wkaczurba/starter-pistol/docs/assets/away_small/away_small.jpg

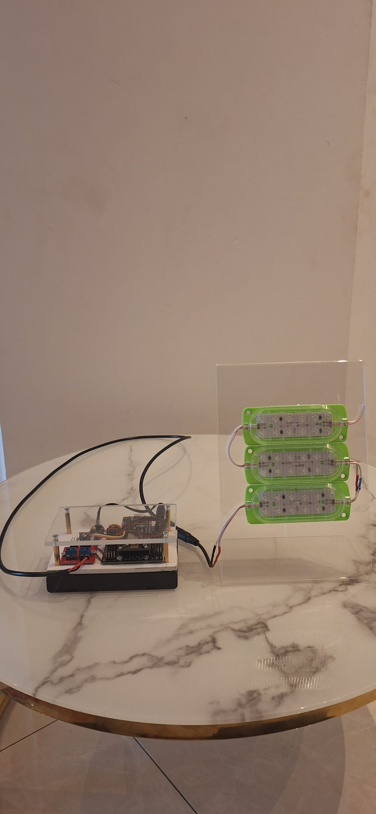
docs/assets/away_small/away_small.jpg
