wkaczurba/starter-pistol/docs/assets/horizontal/horizontal_led_off1.jpg

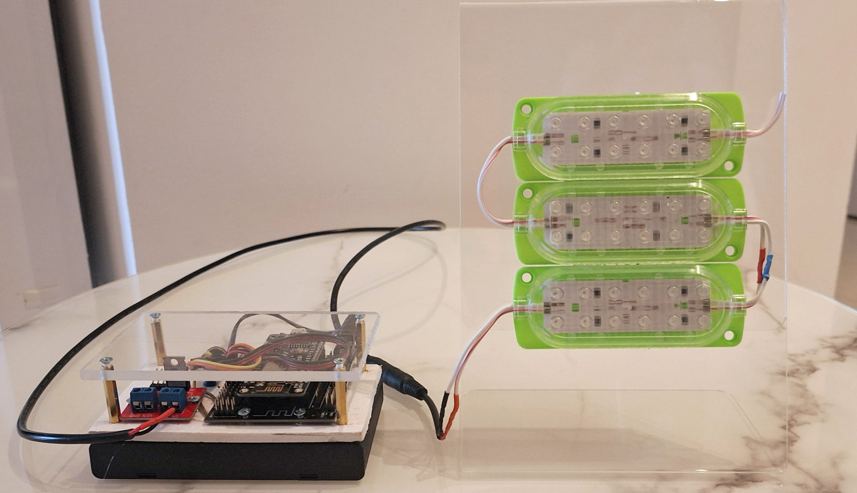
docs/assets/horizontal/horizontal_led_off1.jpg
