wkaczurba/starter-pistol/docs/assets/horizontal/horizontal_led_on1.jpg

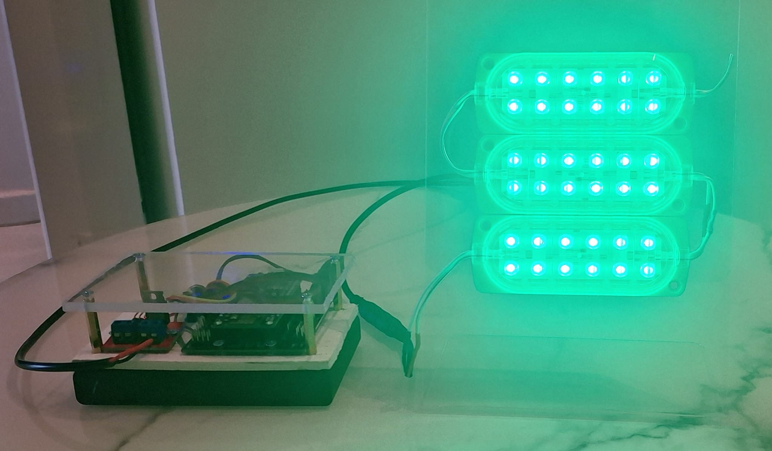
docs/assets/horizontal/horizontal_led_on1.jpg
