wkaczurba/starter-pistol/docs/assets/horizontal/horizontal_led_on2.jpg

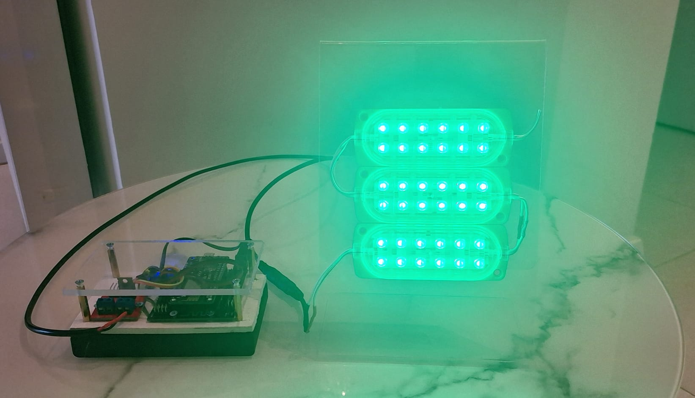
docs/assets/horizontal/horizontal_led_on2.jpg
