wkaczurba/starter-pistol/docs/assets/stacked_zoomedin/stacked1.jpg

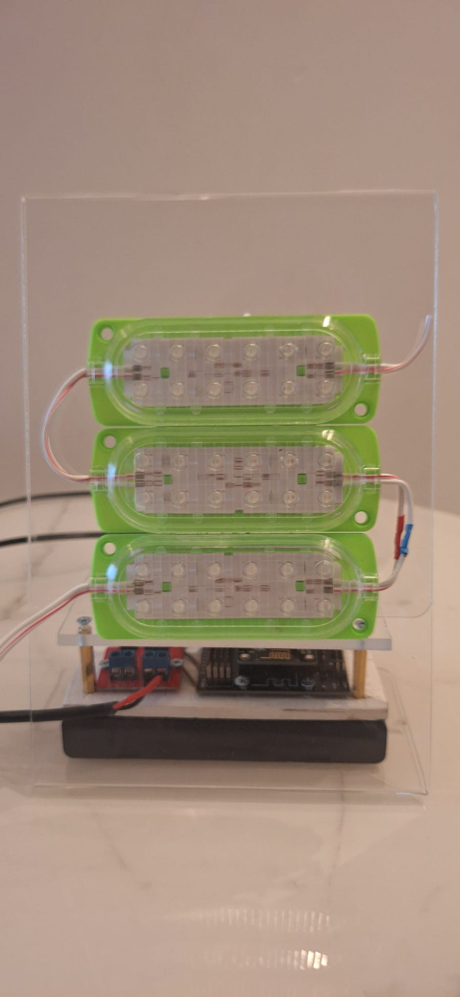
docs/assets/stacked_zoomedin/stacked1.jpg
