wkaczurba/starter-pistol/docs/assets/stacked_zoomedin/stacked2.jpg

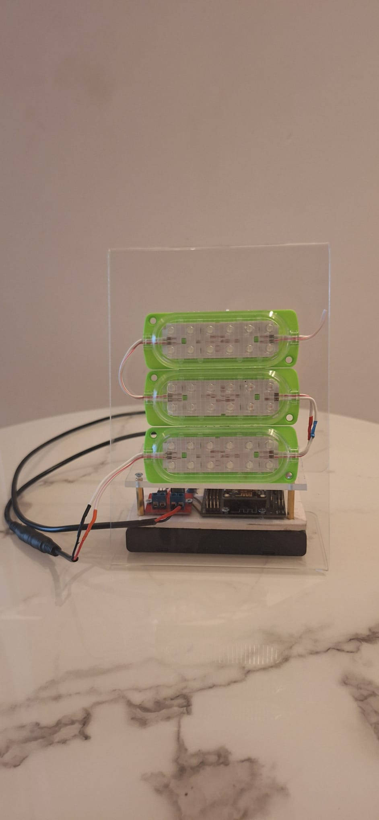
docs/assets/stacked_zoomedin/stacked2.jpg
