wkaczurba/starter-pistol/docs/assets/stand/stand_off1_krzywe.jpg

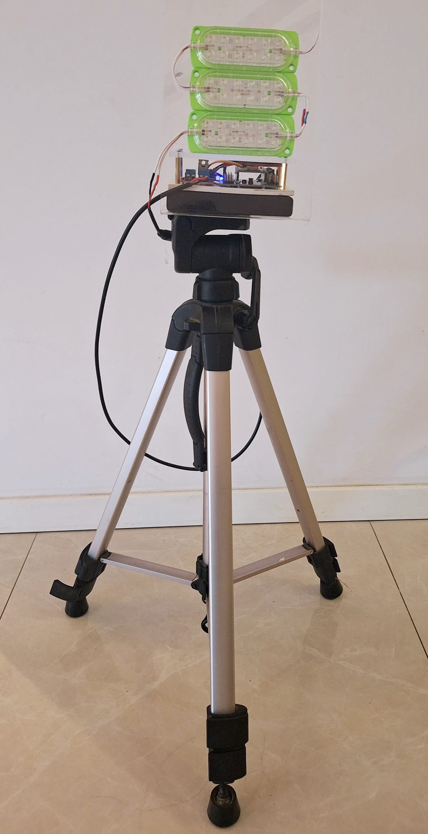
docs/assets/stand/stand_off1_krzywe.jpg
