wkaczurba/starter-pistol/docs/assets/stand/stand_off2_ok.jpg

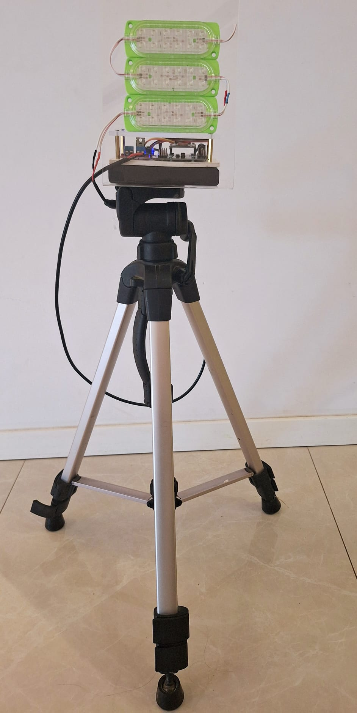
docs/assets/stand/stand_off2_ok.jpg
