wkaczurba/starter-pistol/docs/assets/stand/stand_on1_krzywenieco.jpg

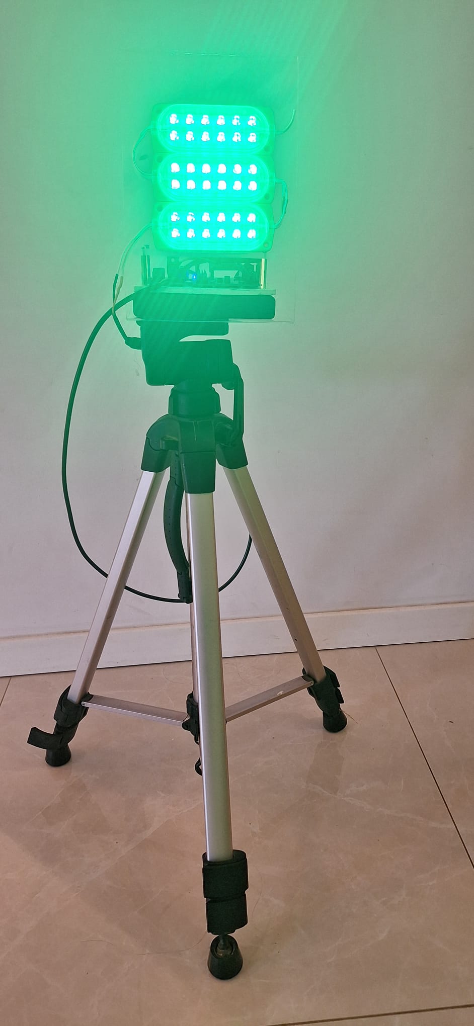
docs/assets/stand/stand_on1_krzywenieco.jpg
