wkaczurba/starter-pistol/docs/assets/stand/stand_on2_ok.jpg

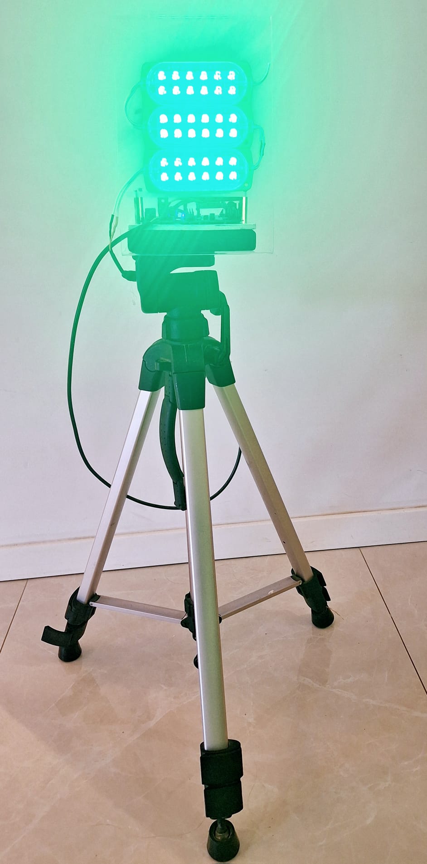
docs/assets/stand/stand_on2_ok.jpg
