wkaczurba/starter-pistol/python/fir_response.png

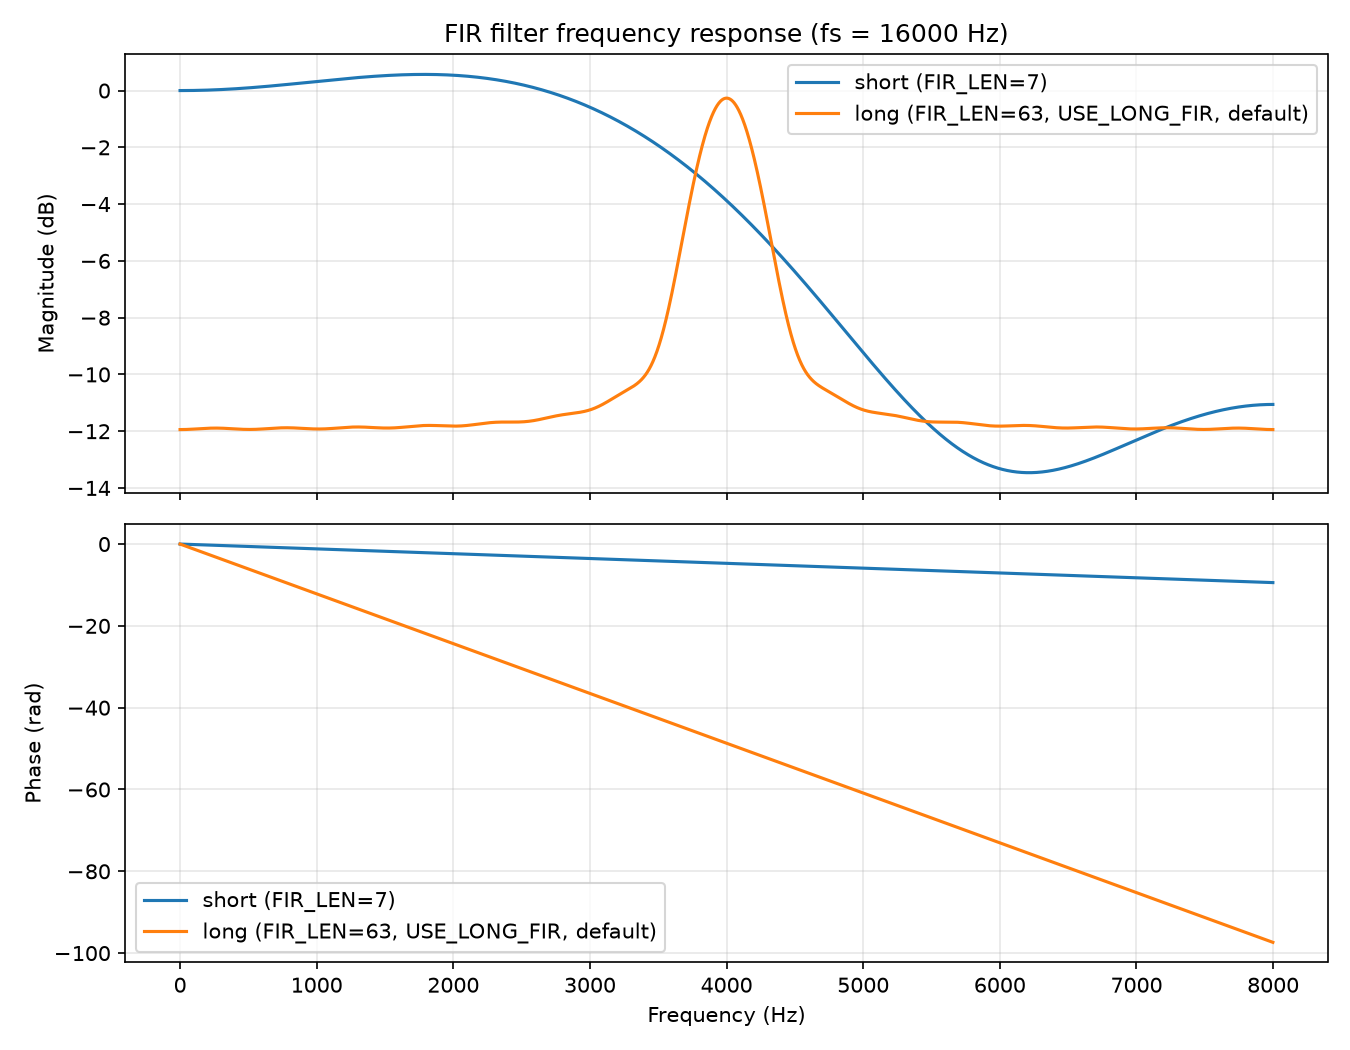
python/fir_response.png
