wkaczurba/starter-pistol/tektronix/ALL0001/F0001TEK.BMP

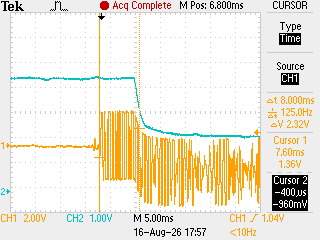
tektronix/ALL0001/F0001TEK.BMP
