wkaczurba/starter-pistol/include/pins.h

#pragma once

// NodeMCU ESP-12E (ESP8266) pin map for this project.
// NodeMCU "Dx" silkscreen labels are used here; see README.md for the
// underlying GPIO numbers and any pin-specific caveats.

#define PIN_MOSFET D0 // Output: gate drive for the MOSFET
